AaronWiersma/LoiterGuardPcb/TopPcbV1.DXF

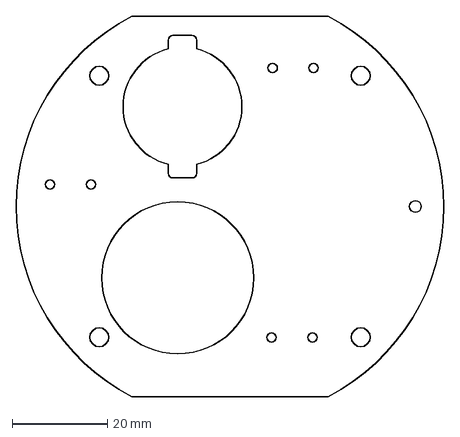
[picture p1: CAD file, 2026-02-07]
TopPcbV1.DXF
90.0 x 80.0 mm
