AaronWiersma/LoiterGuardPcb/LoiterGuardPcb.step

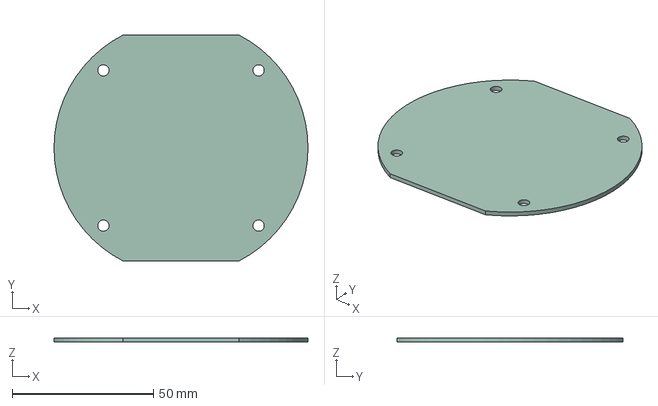
[picture p2: CAD file, 2026-02-04]
LoiterGuardPcb.step
90.0 x 80.0 x 1.51 mm
