AaronWiersma/LoiterGuardPcb/LoiterGuardPcb.kicad_pcb

## KiCad design LoiterGuardPcb.kicad_pcb (2026-02-13)

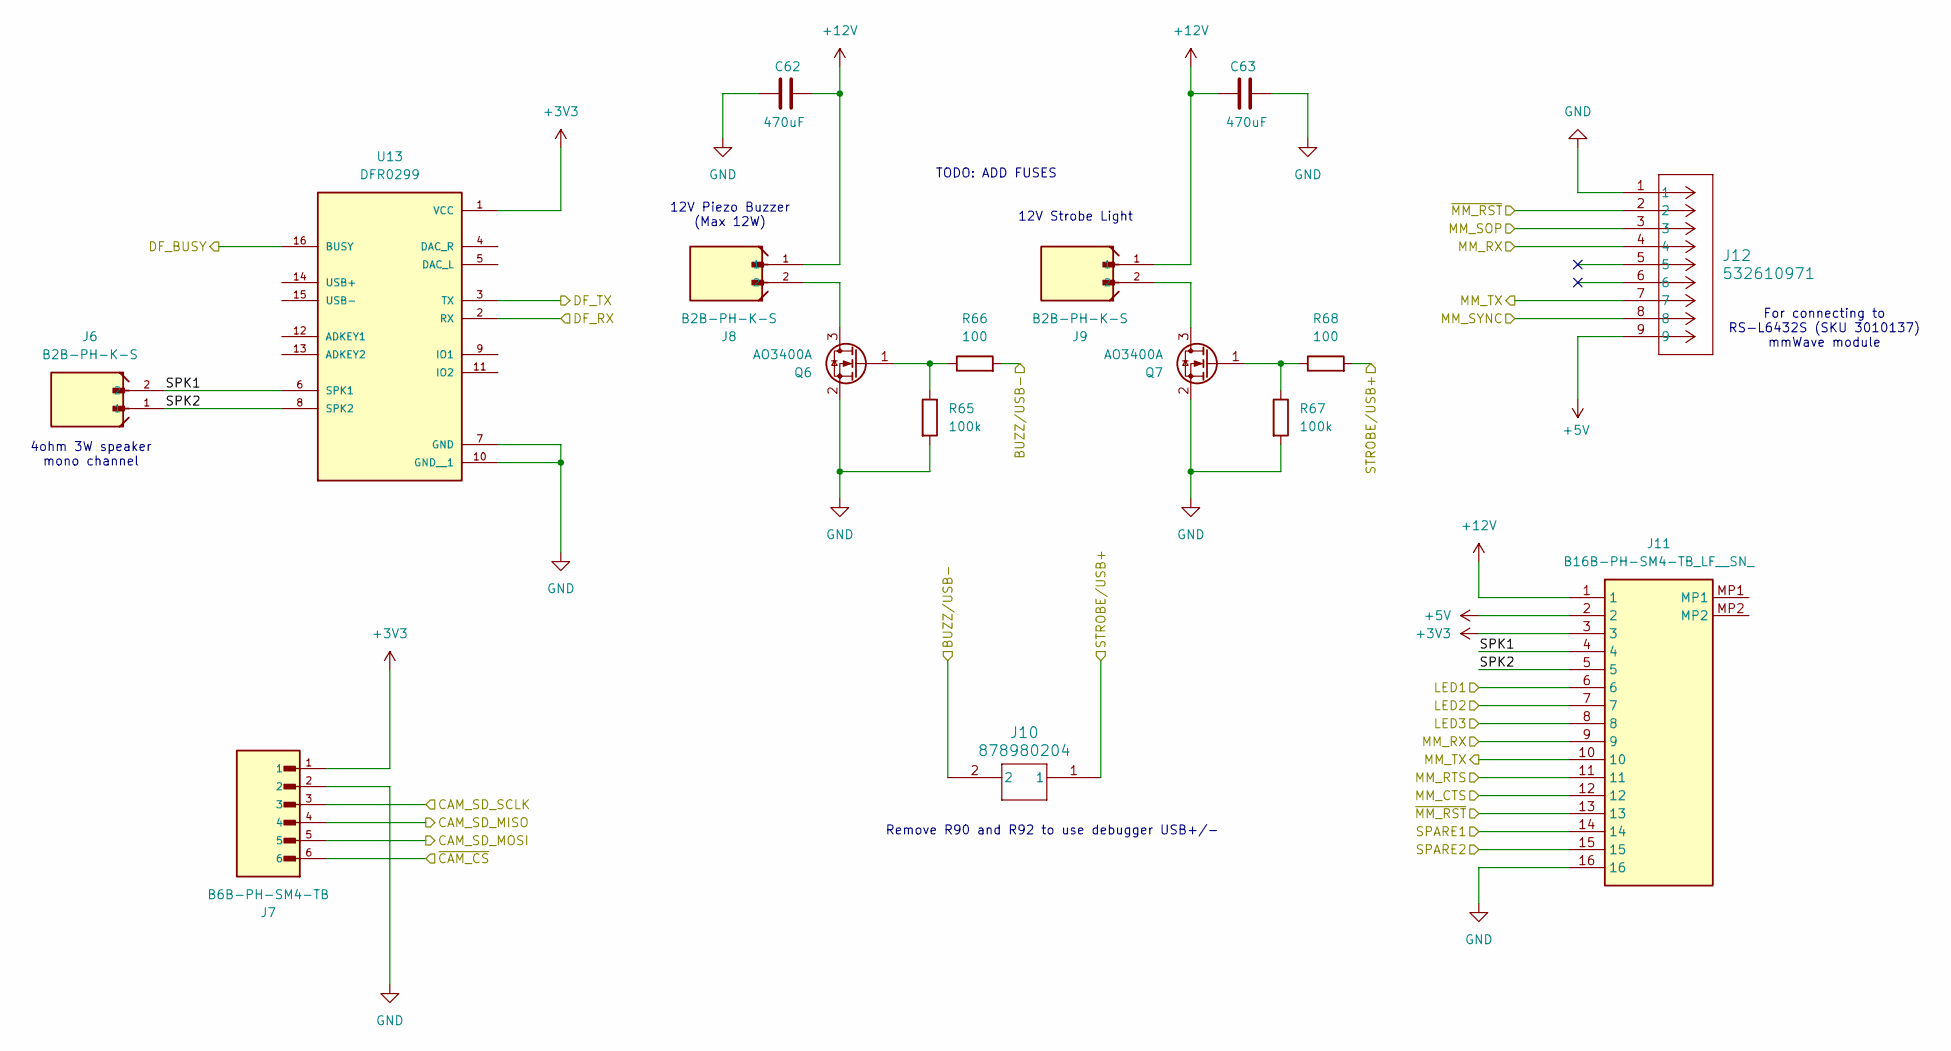
[picture p3: schematic outputs.kicad_sch]

Parts:
C62, C63: 470uF; CP_Radial_D10.0mm_P5.00mm
J6, J8, J9: B2B-PH-K-S; JST_B2B-PH-K-S
J7: B6B-PH-SM4-TB; JST_B6B-PH-SM4-TB; PARTREV N/A
J10: 878980204; 87898-0204_MOL
J11: B16B-PH-SM4-TB_LF__SN_; B16BPHSM4TBLFSN; Manufacturer_Part_Number B16B-PH-SM4-TB(LF)(SN); Mouser Part Number 306-B16BPHSM4TBLFSN
J12: 532610971; CONN_532610001-SD_09_MOL
Q6, Q7: AO3400A; SOT-23
R65, R67: 100k; R_0603_1608Metric
R66, R68: 100; R_0603_1608Metric
U13: DFR0299; MODULE_DFR0299

Connections:
+3V3: J7.1, J11.3, U13.1 (VCC); also elsewhere on the board
+5V: J11.2, J12.9; also elsewhere on the board
+12V: C62.2, C63.2, J8.1, J9.1, J11.1; also elsewhere on the board
/Expander/CAM_SD_MISO: J7.4; also elsewhere on the board
/Expander/CAM_SD_MOSI: J7.5; also elsewhere on the board
/Expander/CAM_SD_SCLK: J7.3; also elsewhere on the board
/Expander/DF_BUSY: U13.16 (BUSY); also elsewhere on the board
/Expander/MM_SOP: J12.3; also elsewhere on the board
/Expander/MM_SYNC: J12.8; also elsewhere on the board
/Expander/SPARE1: J11.15; also elsewhere on the board
/Expander/SPARE2: J11.14; also elsewhere on the board
/Expander/~MM_RST: J11.13, J12.2; also elsewhere on the board
/MCU/BUZZ/USB-: J10.2, R66.2; also elsewhere on the board
/MCU/DF_RX: U13.2 (RX); also elsewhere on the board
/MCU/DF_TX: U13.3 (TX); also elsewhere on the board
/MCU/LED1: J11.6; also elsewhere on the board
/MCU/LED2: J11.7; also elsewhere on the board
/MCU/LED3: J11.8; also elsewhere on the board
/MCU/MM_CTS: J11.12; also elsewhere on the board
/MCU/MM_RTS: J11.11; also elsewhere on the board
/MCU/MM_RX: J11.9, J12.4; also elsewhere on the board
/MCU/MM_TX: J11.10, J12.7; also elsewhere on the board
/MCU/STROBE/USB+: J10.1, R68.2; also elsewhere on the board
/MCU/~CAM_CS: J7.6; also elsewhere on the board
/Outputs/SPK1: J6.2, J11.4, U13.6 (SPK1)
/Outputs/SPK2: J6.1, J11.5, U13.8 (SPK2)
GND: C62.1, C63.1, J7.2, J11.16, J12.1, Q6.2 (S), Q7.2 (S), R65.2, R67.2, U13.7 (GND), U13.10 (GND__1); also elsewhere on the board
unnamed: J8.2, Q6.3 (D)
unnamed: Q6.1 (G), R65.1, R66.1
unnamed: J9.2, Q7.3 (D)
unnamed: Q7.1 (G), R67.1, R68.1

Notes on the sheet:
TODO: ADD FUSES
12V Strobe Light
Remove R90 and R92 to use debugger USB+/-
12V Piezo Buzzer (Max 12W)
4ohm 3W speaker mono channel
For connecting to RS-L6432S (SKU 3010137) mmWave module

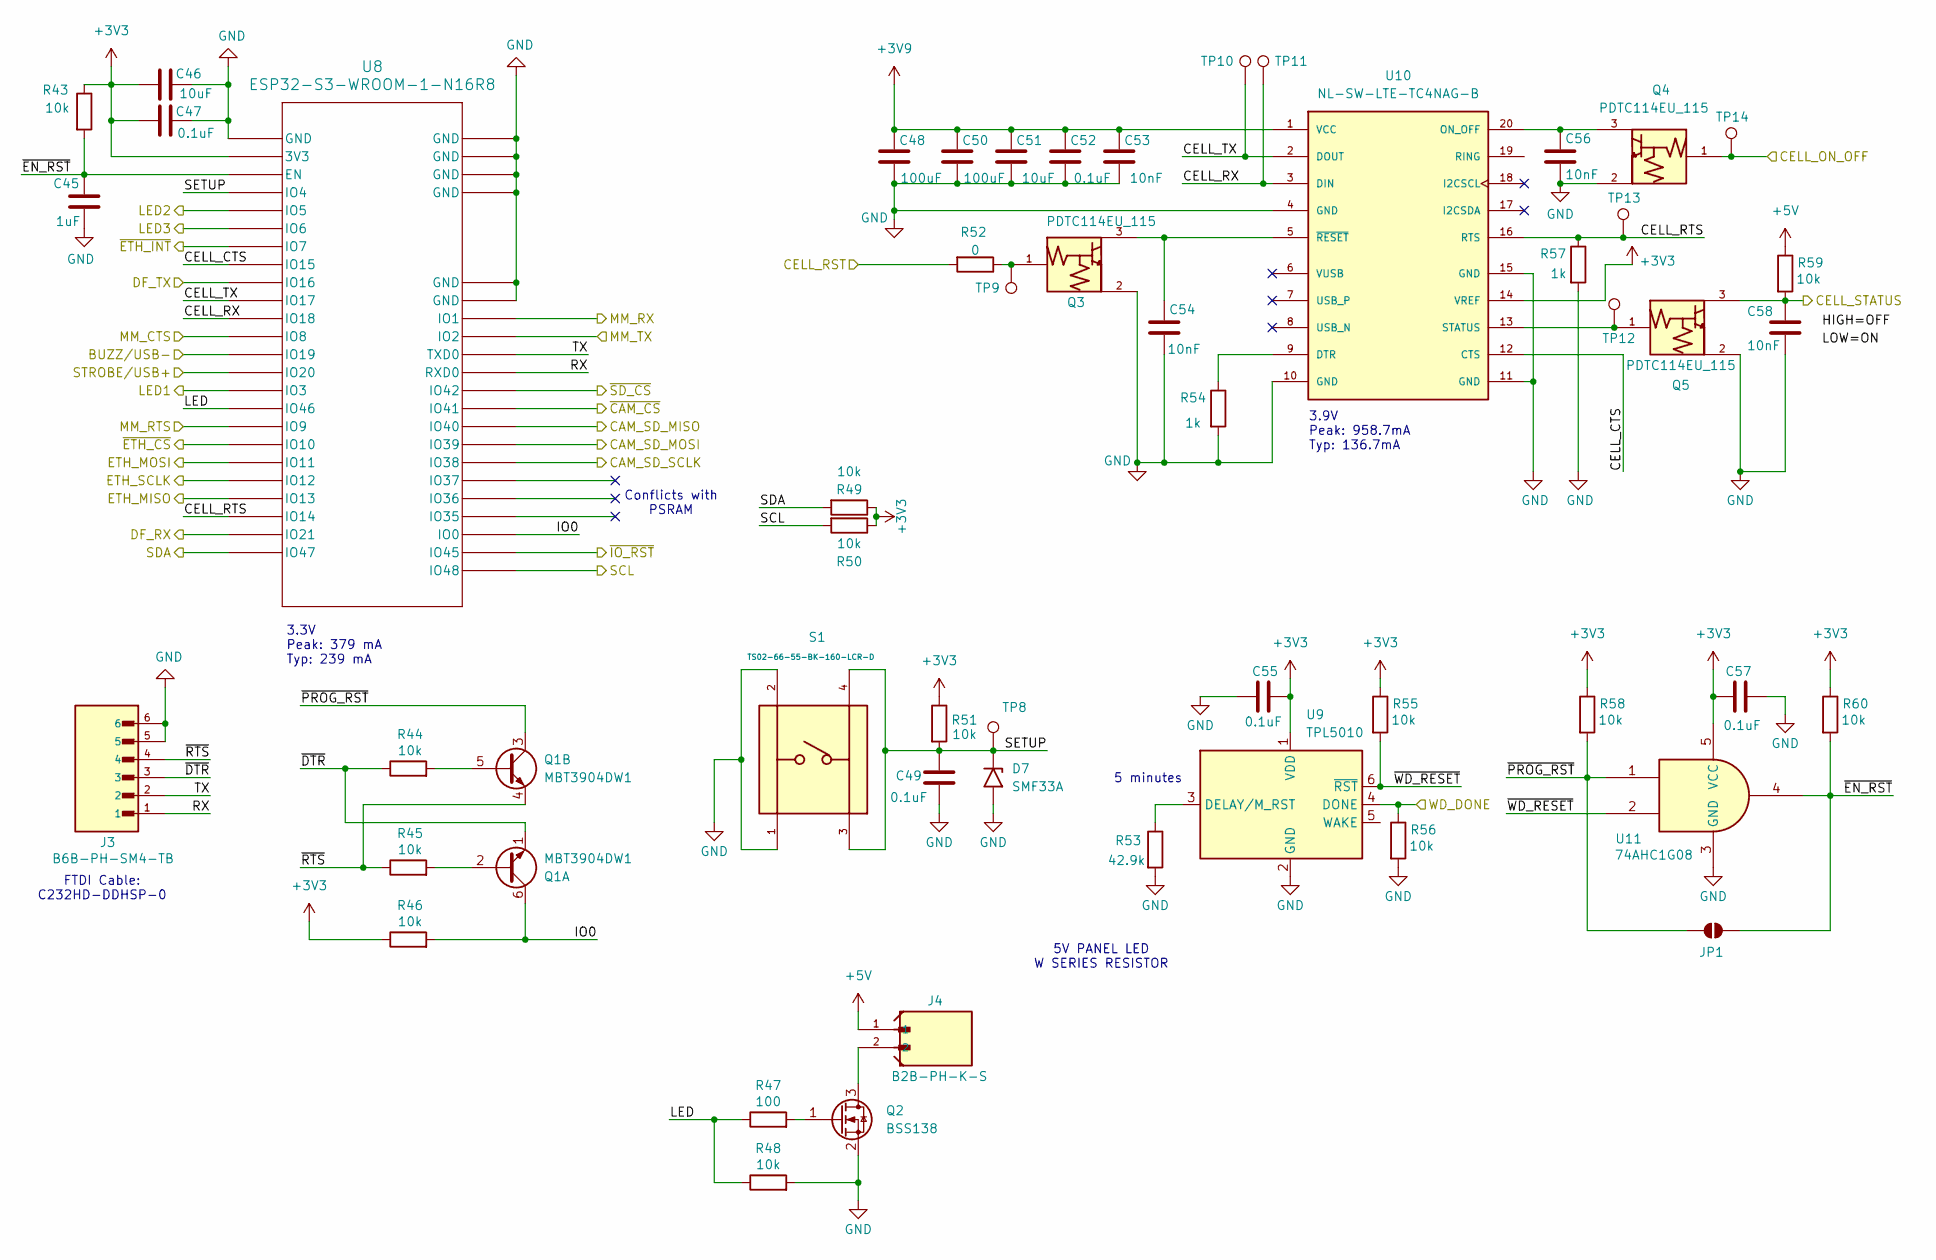
[picture p4: schematic MCU.kicad_sch]

Parts:
C45: 1uF; C_0603_1608Metric
C46, C51: 10uF; C_0805_2012Metric
C47, C49, C52, C55, C57: 0.1uF; C_0603_1608Metric
C48, C50: 100uF; CAPMP7.6X4.3_4.3N_KEM
C53, C54, C56, C58: 10nF; C_0603_1608Metric
D7: SMF33A; D_SMF
J3: B6B-PH-SM4-TB; JST_B6B-PH-SM4-TB; PARTREV N/A
J4: B2B-PH-K-S; JST_B2B-PH-K-S
JP1: SolderJumper_2_Open; SolderJumper-2_P1.3mm_Open_Pad1.0x1.5mm
Q1: MBT3904DW1; SOT-363_SC-70-6
Q2: BSS138; SOT-23
Q3, Q4, Q5: PDTC114EU_115; SOT65P210X110-3N; PARTREV 12
R43, R44, R45, R46, R48, R51, R55, R56, R58, R59, R60: 10k; R_0603_1608Metric
R47: 100; R_0603_1608Metric
R49, R50: 10k_0402_0402WGF1002TCE; R_0402_1005Metric; Tolerance 1%; MPN 0402WGF1002TCE
R52: 0; R_0603_1608Metric
R53: 42.9k; R_0603_1608Metric
R54, R57: 1k; R_0603_1608Metric
S1: TS02-66-55-BK-160-LCR-D; SW_TS02-66-55-BK-160-LCR-D; PARTREV 1.0
TP8, TP9, TP10, TP11, TP12, TP13, TP14: TestPoint; TestPoint_Pad_D2.0mm
U8: ESP32-S3-WROOM-1-N16R8; ESP32-S3-WROOM-1_EXP
U9: TPL5010; SOT-23-6
U10: NL-SW-LTE-TC4NAG-B; MODULE_NL-SW-LTE-QBG96; PARTREV 16
U11: 74AHC1G08; SOT95P280X140-5N

Connections:
+3V3: C46.1, C47.1, C55.2, C57.1, R43.1, R46.1, R49.1, R50.1, R51.1, R55.1, R58.1, R60.1, U8.2 (3V3), U9.1 (VDD), U10.14 (VREF), U11.5 (VCC); also elsewhere on the board
+3V9: C48.1, C50.1, C51.1, C52.1, C53.1, U10.1 (VCC); also elsewhere on the board
+5V: J4.1, R59.1; also elsewhere on the board
/Expander/CAM_SD_MISO: U8.33 (IO40); also elsewhere on the board
/Expander/CAM_SD_MOSI: U8.32 (IO39); also elsewhere on the board
/Expander/CAM_SD_SCLK: U8.31 (IO38); also elsewhere on the board
/Expander/CELL_ON_OFF: Q4.1, TP14.1; also elsewhere on the board
/Expander/CELL_RST: R52.2; also elsewhere on the board
/Expander/CELL_STATUS: C58.1, Q5.3, R59.2; also elsewhere on the board
/Expander/WD_DONE: R56.1, U9.4 (DONE); also elsewhere on the board
/Expander/~IO_RST: U8.26 (IO45); also elsewhere on the board
/Expander/~SD_CS: U8.35 (IO42); also elsewhere on the board
/MCU/BUZZ/USB-: U8.13 (IO19); also elsewhere on the board
/MCU/CELL_CTS: U8.8 (IO15), U10.12 (CTS)
/MCU/CELL_RTS: R57.1, TP13.1, U8.22 (IO14), U10.16 (RTS)
/MCU/CELL_RX: TP11.1, U8.11 (IO18), U10.3 (DIN)
/MCU/CELL_TX: TP10.1, U8.10 (IO17), U10.2 (DOUT)
/MCU/DF_RX: U8.23 (IO21); also elsewhere on the board
/MCU/DF_TX: U8.9 (IO16); also elsewhere on the board
/MCU/ETH_MISO: U8.21 (IO13); also elsewhere on the board
/MCU/ETH_MOSI: U8.19 (IO11); also elsewhere on the board
/MCU/ETH_SCLK: U8.20 (IO12); also elsewhere on the board
/MCU/IO0: Q1.6 (C1), R46.2, U8.27 (IO0)
/MCU/LED: R47.1, R48.1, U8.16 (IO46)
/MCU/LED1: U8.15 (IO3); also elsewhere on the board
/MCU/LED2: U8.5 (IO5); also elsewhere on the board
/MCU/LED3: U8.6 (IO6); also elsewhere on the board
/MCU/MM_CTS: U8.12 (IO8); also elsewhere on the board
/MCU/MM_RTS: U8.17 (IO9); also elsewhere on the board
/MCU/MM_RX: U8.39 (IO1); also elsewhere on the board
/MCU/MM_TX: U8.38 (IO2); also elsewhere on the board
/MCU/RX: J3.1, U8.36 (RXD0)
/MCU/SCL: R50.2, U8.25 (IO48); also elsewhere on the board
/MCU/SDA: R49.2, U8.24 (IO47); also elsewhere on the board
/MCU/SETUP: C49.1, D7.1 (A1), R51.2, S1.3, S1.4, TP8.1, U8.4 (IO4)
/MCU/STROBE/USB+: U8.14 (IO20); also elsewhere on the board
/MCU/TX: J3.2, U8.37 (TXD0)
/MCU/~CAM_CS: U8.34 (IO41); also elsewhere on the board
/MCU/~DTR: J3.3, Q1.1 (E1), R44.1
/MCU/~EN_RST: C45.2, JP1.2 (B), R43.2, R60.2, U8.3 (EN), U11.4
/MCU/~ETH_CS: U8.18 (IO10); also elsewhere on the board
/MCU/~ETH_INT: U8.7 (IO7); also elsewhere on the board
/MCU/~PROG_RST: JP1.1 (A), Q1.3 (C2), R58.2, U11.1
/MCU/~RTS: J3.4, Q1.4 (E2), R45.1
/MCU/~WD_RESET: R55.2, U9.6 (~RST), U11.2
GND: C45.1, C46.2, C47.2, C48.2, C49.2, C50.2, C51.2, C52.2, C53.2, C54.2, C55.1, C56.2, C57.2, C58.2, D7.2 (A2), J3.5, J3.6, Q2.2 (S), Q3.2, Q4.2, Q5.2, R48.2, R53.2, R54.2, R56.2, R57.2, S1.1, S1.2, U8.1 (GND), U8.40 (GND), U8.41 (GND), U8.46 (GND), U8.47 (GND), U8.48 (GND), U8.49 (GND), U9.2 (GND), U10.4 (GND), U10.10 (GND), U10.11 (GND), U10.15 (GND), U11.3 (GND); also elsewhere on the board
unnamed: Q1.2 (B1), R45.2
unnamed: Q1.5 (B2), R44.2
unnamed: J4.2, Q2.3 (D)
unnamed: Q2.1 (G), R47.2
unnamed: Q3.1, R52.1, TP9.1
unnamed: R53.1, U9.3 (DELAY/M_RST)
unnamed: R54.1, U10.9 (DTR)
unnamed: C56.1, Q4.3, U10.20 (ON_OFF)
unnamed: Q5.1, TP12.1, U10.13 (STATUS)
unnamed: C54.1, Q3.3, U10.5 (~RESET)

Notes on the sheet:
3.3V Peak: 379 mA Typ: 239 mA
3.9V Peak: 958.7mA Typ: 136.7mA
5V PANEL LED W SERIES RESISTOR
FTDI Cable: C232HD-DDHSP-0
5 minutes
Conflicts with PSRAM

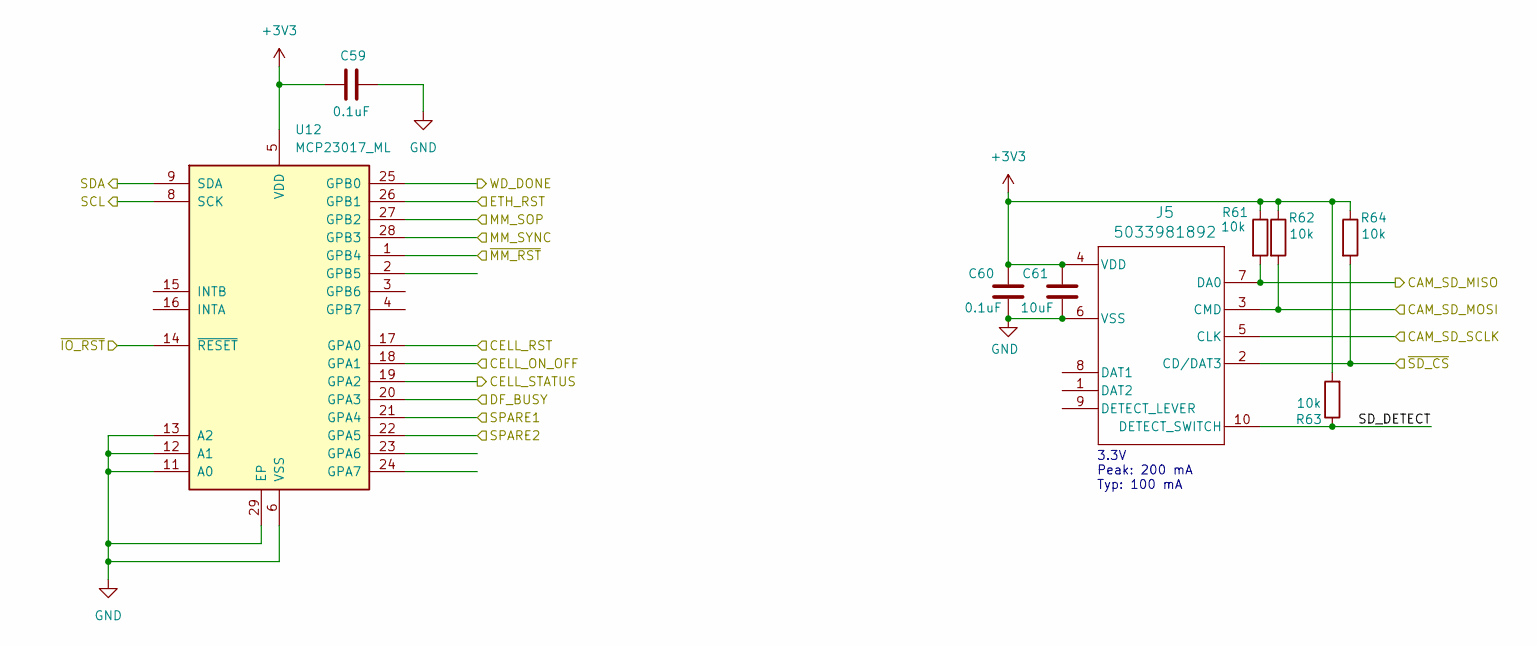
[picture p5: schematic expander.kicad_sch]

Parts:
C59, C60: 0.1uF; C_0603_1608Metric
C61: 10uF; C_0805_2012Metric
J5: 5033981892; CONN_503398-1892_MOL
R61, R62, R63, R64: 10k; R_0603_1608Metric
U12: MCP23017_ML; QFN-28-1EP_6x6mm_P0.65mm_EP4.25x4.25mm

Connections:
+3V3: C59.1, C60.1, C61.1, J5.4 (VDD), R61.1, R62.1, R63.2, R64.1, U12.5 (VDD); also elsewhere on the board
/Expander/CAM_SD_MISO: J5.7 (DA0), R61.2; also elsewhere on the board
/Expander/CAM_SD_MOSI: J5.3 (CMD), R62.2; also elsewhere on the board
/Expander/CAM_SD_SCLK: J5.5 (CLK); also elsewhere on the board
/Expander/CELL_ON_OFF: U12.18 (GPA1); also elsewhere on the board
/Expander/CELL_RST: U12.17 (GPA0); also elsewhere on the board
/Expander/CELL_STATUS: U12.19 (GPA2); also elsewhere on the board
/Expander/DF_BUSY: U12.20 (GPA3); also elsewhere on the board
/Expander/ETH_RST: U12.26 (GPB1); also elsewhere on the board
/Expander/MM_SOP: U12.27 (GPB2); also elsewhere on the board
/Expander/MM_SYNC: U12.28 (GPB3); also elsewhere on the board
/Expander/SD_DETECT: J5.10 (DETECT_SWITCH), R63.1
/Expander/SPARE1: U12.21 (GPA4); also elsewhere on the board
/Expander/SPARE2: U12.22 (GPA5); also elsewhere on the board
/Expander/WD_DONE: U12.25 (GPB0); also elsewhere on the board
/Expander/~IO_RST: U12.14 (~RESET); also elsewhere on the board
/Expander/~MM_RST: U12.1 (GPB4); also elsewhere on the board
/Expander/~SD_CS: J5.2 (CD/DAT3), R64.2; also elsewhere on the board
/MCU/SCL: U12.8 (SCK); also elsewhere on the board
/MCU/SDA: U12.9 (SDA); also elsewhere on the board
GND: C59.2, C60.2, C61.2, J5.6 (VSS), U12.6 (VSS), U12.11 (A0), U12.12 (A1), U12.13 (A2), U12.29 (EP); also elsewhere on the board

Notes on the sheet:
3.3V Peak: 200 mA Typ: 100 mA

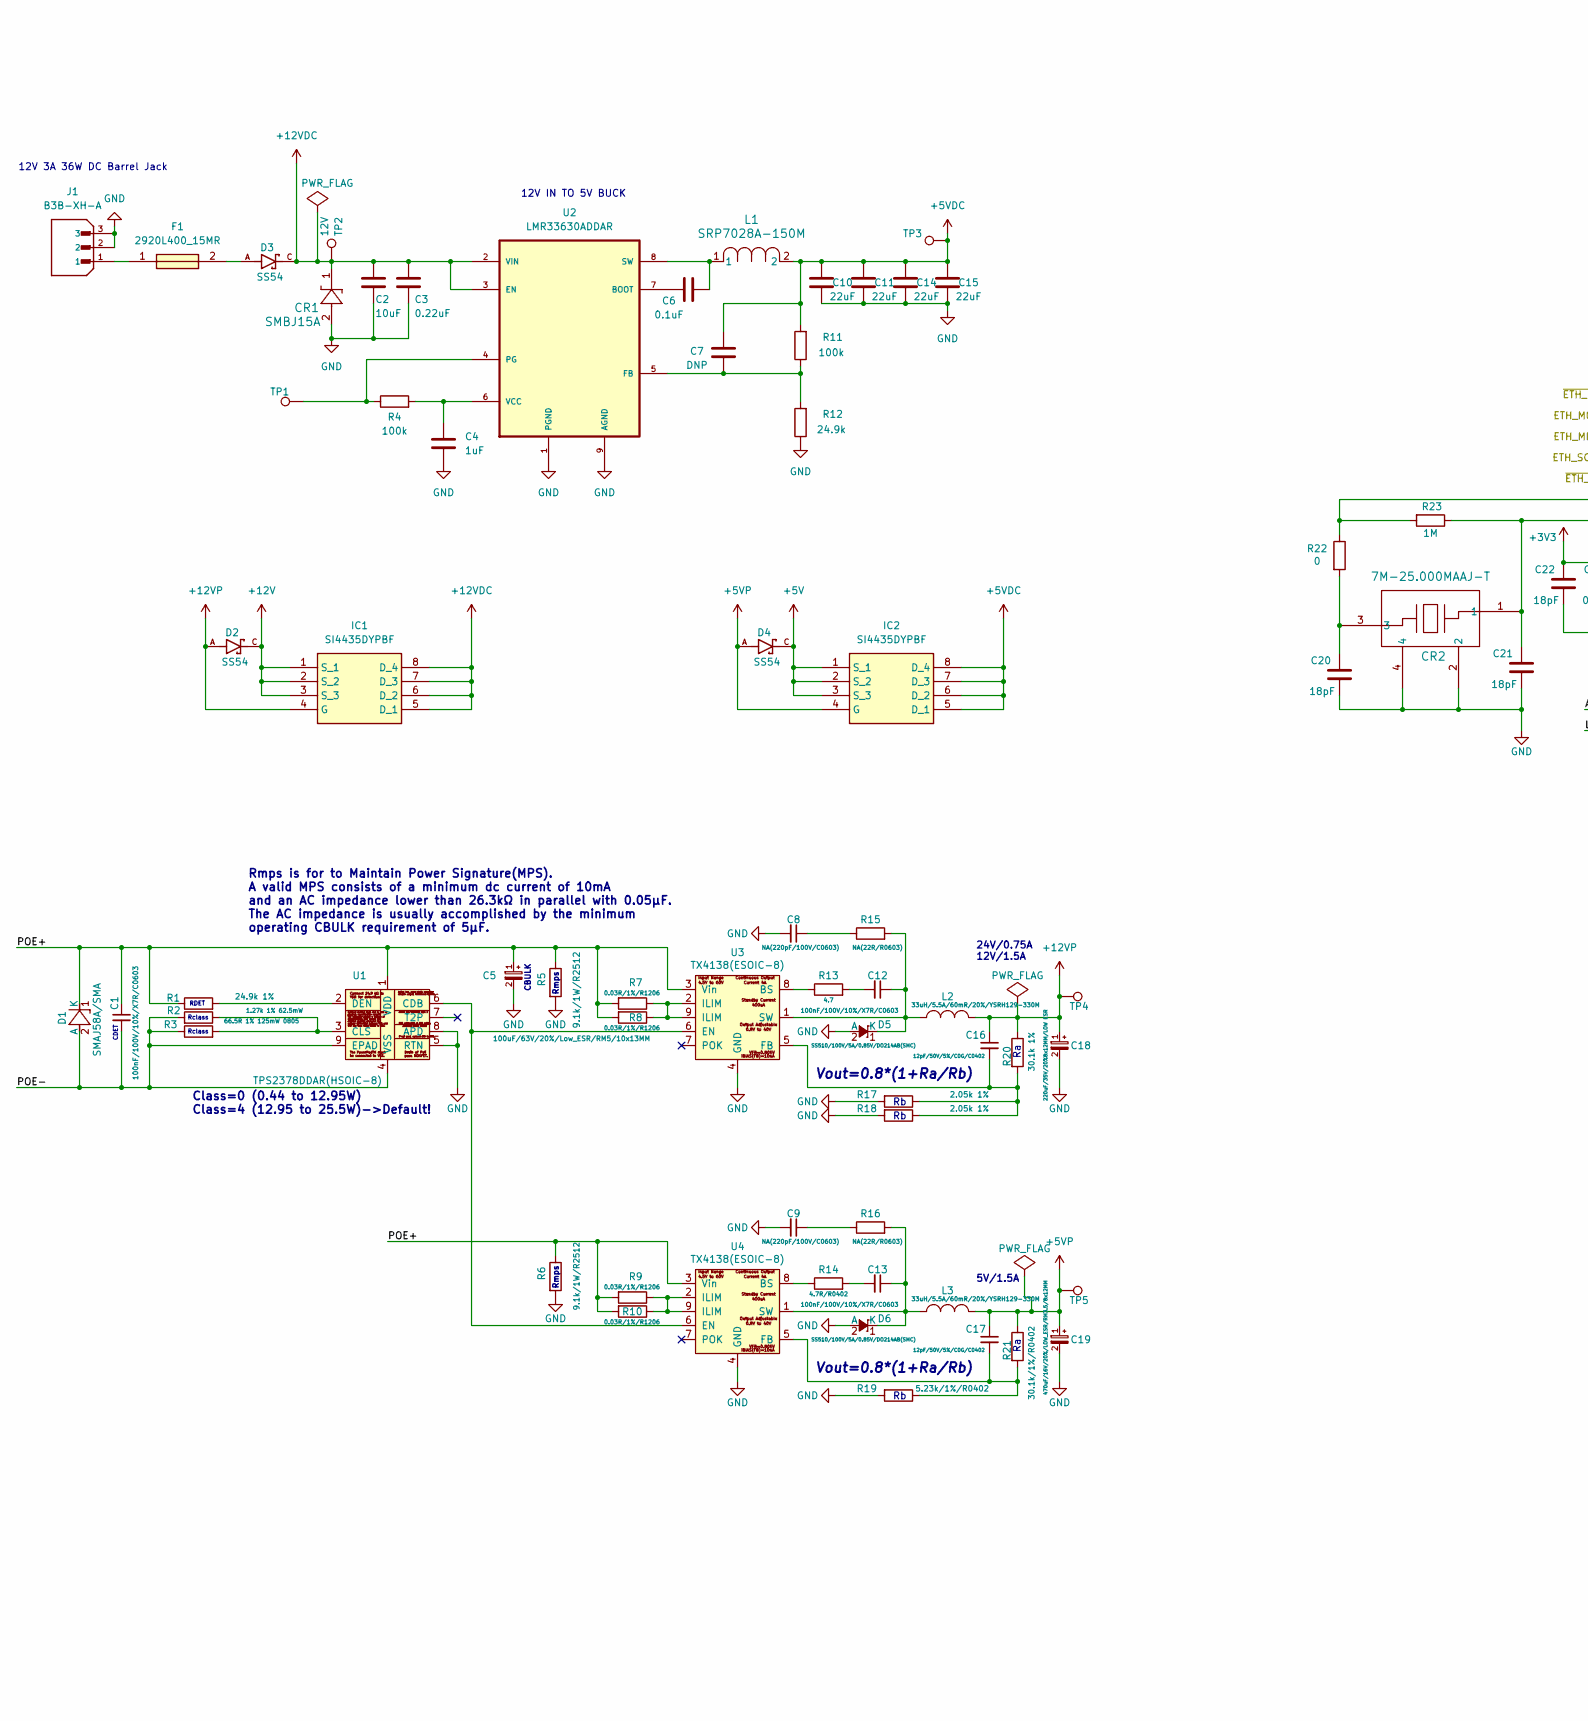
[picture p6: schematic ESP32-PoE2_Rev_B.kicad_sch, part in row 1, column 1]

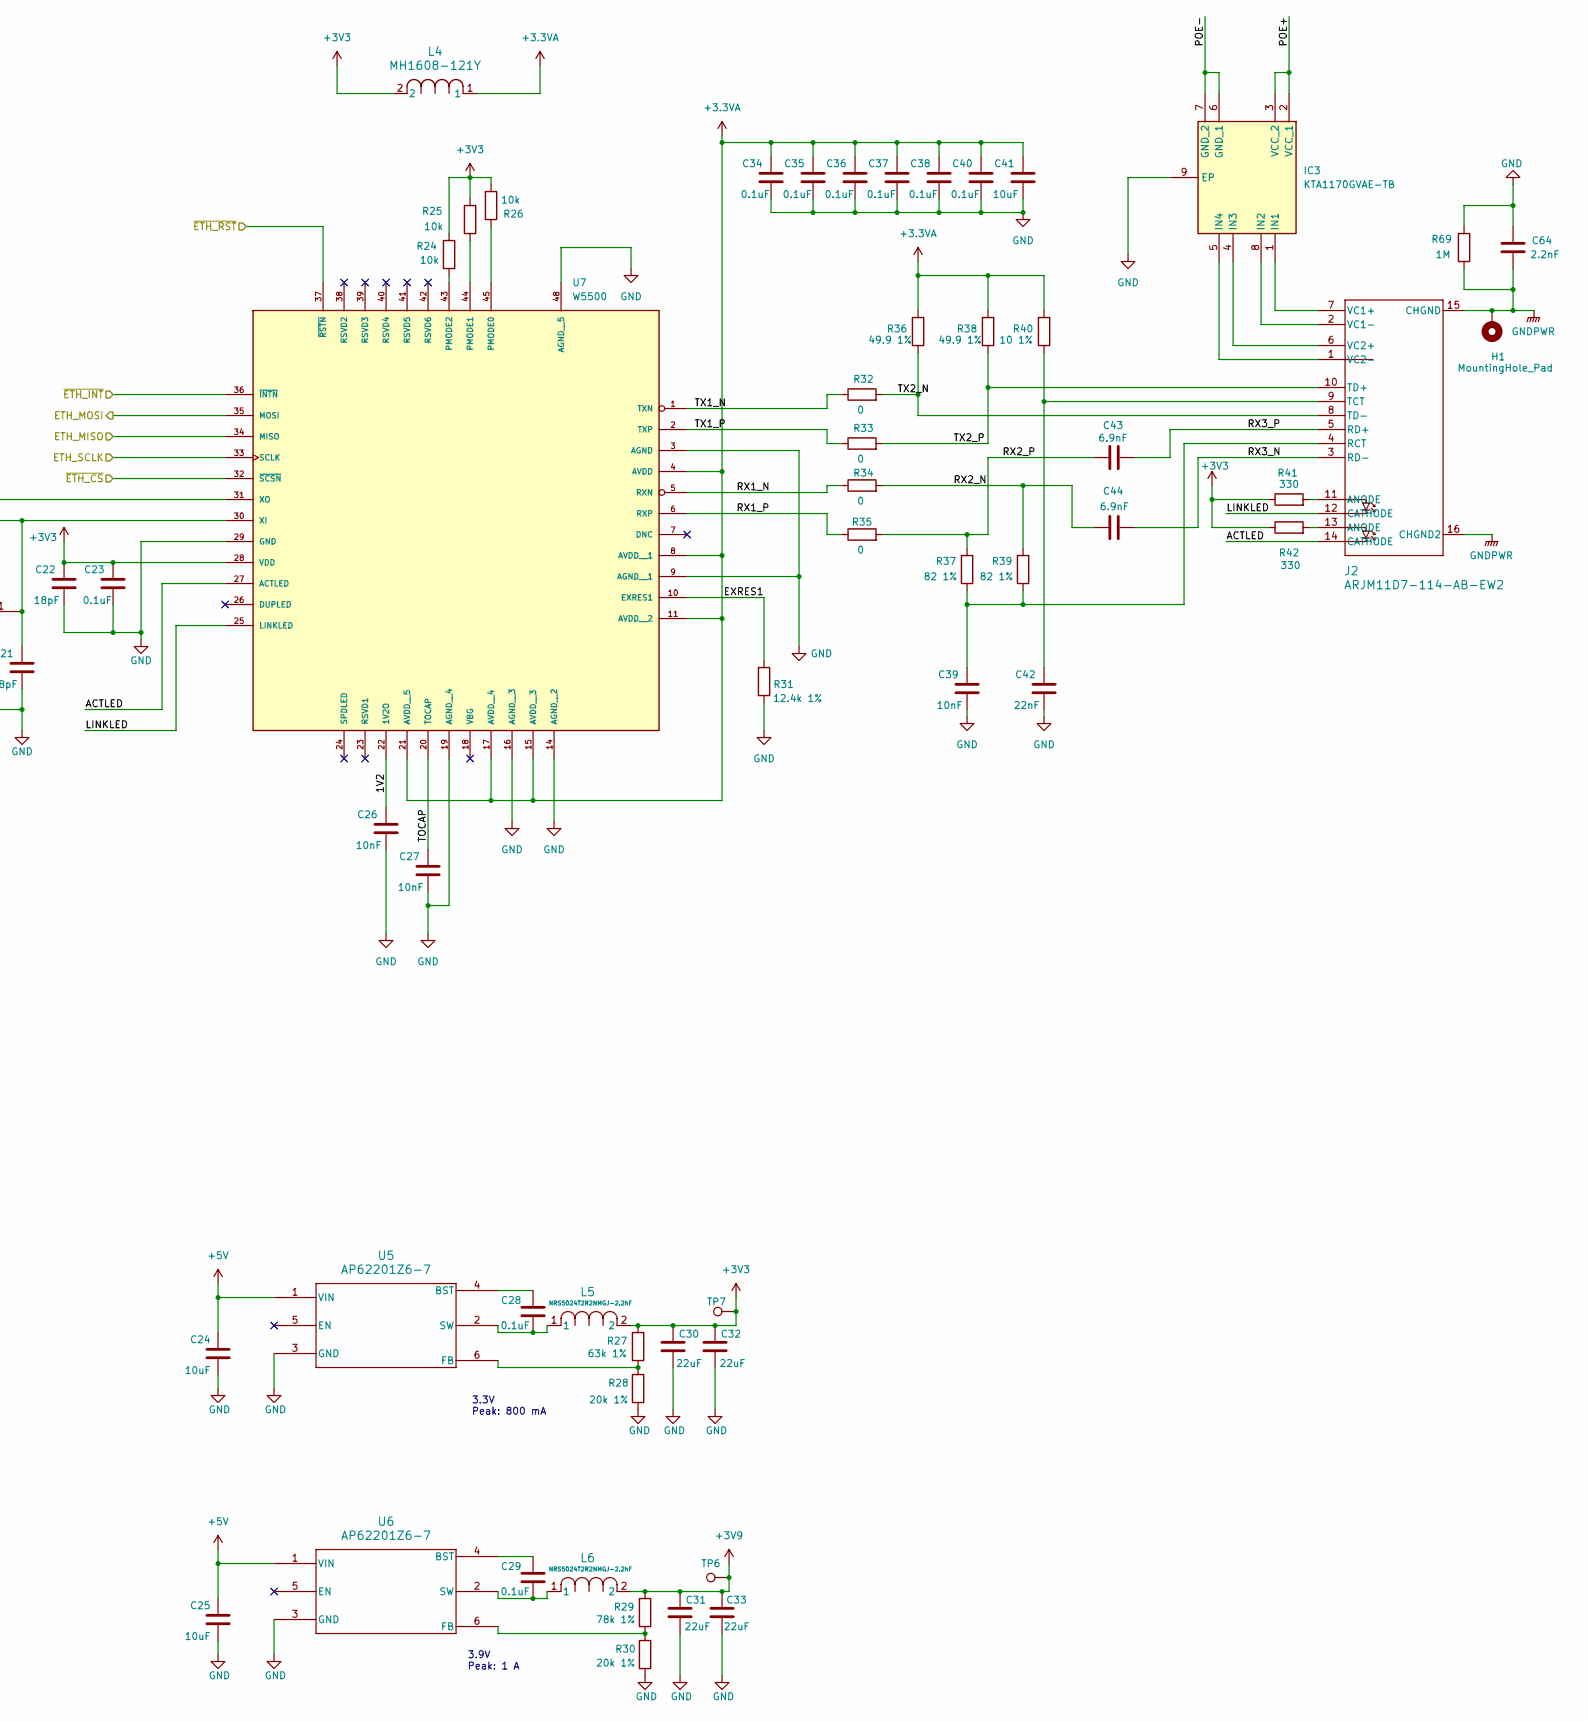
[picture p7: schematic ESP32-PoE2_Rev_B.kicad_sch, part in row 1, column 2]

Parts:
C1: 100nF/100V/10%/X7R/C0603; C_0603_1608Metric
C2, C24, C25: 10uF; C_0805_2012Metric
C3: 0.22uF; C_0603_1608Metric
C4: 1uF; C_0603_1608Metric
C5: 100uF/63V/20%/Low_ESR/RM5/10x13MM; CPOL-RM5mm_10.0x16.0mm_PTH
C6, C23, C28, C29, C34, C35, C36, C37, C38, C40: 0.1uF; C_0603_1608Metric
C7: DNP; C_0603_1608Metric
C8, C9: NA(220pF/100V/C0603); C_0603_5MIL_DWS
C10, C11, C14, C15, C30, C31, C32, C33: 22uF; C_0805_2012Metric
C12, C13: 100nF/100V/10%/X7R/C0603; C_0603_5MIL_DWS
C16, C17: 12pF/50V/5%/C0G/C0402; C_0402_5MIL_DWS
C18: 220uF/35V/20%8x12MM/LOW ESR; CPOL-RM3.5mm_8.0x11.5mm_PTH
C19: 470uF/16V/20%/LOW_ESR/RM3.5/8x12MM; CPOL-RM3.5mm_8.0x11.5mm_PTH
C20, C21, C22: 18pF; C_0603_1608Metric
C26, C27, C39: 10nF; C_0603_1608Metric
C41: 10uF; C_0603_1608Metric
C42: 22nF; C_1206_3216Metric
C43, C44: 6.9nF; C_1206_3216Metric
C64: 2.2nF; C_1812_4532Metric
CR1: SMBJ15A; DO-214AASMB_J-BEND_LTF
CR2: 7M-25.000MAAJ-T; CRYSTAL_TXC_7M
D1: SMAJ58A/SMA; SMA-KA
D2, D3, D4: SS54; DIOM7959X265N; PARTREV 31 Aug 2016
D5, D6: SS510/100V/5A/0.85V/DO214AB(SMC); DO214AB(SMC)_1(K)-2(A)
F1: 2920L400_15MR; 2920L07560MR; Manufacturer_Part_Number 2920L400/15MR; Mouser Part Number 576-2920L400/15MR
H1: MountingHole_Pad; MountingHole_3mm_Pad_TopOnly
IC1, IC2: SI4435DYPBF; SOIC127P600X175-8N; Manufacturer_Part_Number SI4435DYPBF; Mouser Part Number 942-SI4435DYPBF
IC3: KTA1170GVAE-TB; SON65P400X400X80-9N; Manufacturer_Part_Number KTA1170GVAE-TB; Mouser Part Number 389-KTA1170GVAE-TB
J1: B3B-XH-A; JST_B3B-XH-A; PARTREV 7/4/21
J2: ARJM11D7-114-AB-EW2; CONN_ARJM11D7-114-AB-EW2_ABR
L1: SRP7028A-150M; IND_SRP7028A_BRN
L2, L3: 33uH/5.5A/60mR/20%/YSRH129-330M; HSMRH129_12.0x12.5x9.5(max)
L4: MH1608-121Y; IND_BOURNS_MH1608
L5, L6: NRS5024T2R2NMGJ-2.2hF; IND_NRS5024_TAY
R1: 24.9k 1%; R_0402_5MIL_DWS
R2: 1.27k 1% 62.5mW; R_0402_5MIL_DWS
R3: 66.5R 1% 125mW 0805; R_0805_5MIL_DWS
R4, R11: 100k; R_0603_1608Metric
R5, R6: 9.1k/1W/R2512; R_2512_MM_DWS
R7, R8, R9, R10: 0.03R/1%/R1206; R_1206_5MIL_DWS
R12: 24.9k; R_0603_1608Metric
R13: 4.7; R_0402_5MIL_DWS
R14: 4.7R/R0402; R_0402_5MIL_DWS
R15, R16: NA(22R/R0603); R_0603_5MIL_DWS
R17, R18: 2.05k 1%; R_0402_5MIL_DWS
R19: 5.23k/1%/R0402; R_0402_5MIL_DWS
R20: 30.1k 1%; R_0402_5MIL_DWS
R21: 30.1k/1%/R0402; R_0402_5MIL_DWS
R22, R32, R33, R34, R35: 0; R_0603_1608Metric
R23: 1M; R_0603_1608Metric
R24, R25, R26: 10k; R_0603_1608Metric
R27: 63k 1%; R_0603_1608Metric
R28, R30: 20k 1%; R_0603_1608Metric
R29: 78k 1%; R_0603_1608Metric
R31: 12.4k 1%; R_0603_1608Metric
R36, R38: 49.9 1%; R_0603_1608Metric
R37, R39: 82 1%; R_0603_1608Metric
R40: 10 1%; R_0603_1608Metric
R41, R42: 330; R_0603_1608Metric
R69: 1M; R_1206_3216Metric
TP1: TestPoint; TestPoint_Pad_D2.0mm
TP2: 12V; TestPoint_Pad_D2.0mm
TP3: 5VIN; TestPoint_Pad_D2.0mm
TP4, TP5, TP7: 3V3; TestPoint_Pad_D2.0mm
TP6: 3V9; TestPoint_Pad_D2.0mm
U1: TPS2378DDAR(HSOIC-8); ESOIC-8
U2: LMR33630ADDAR; VREG_LM5017MR_NOPB
U3, U4: TX4138(ESOIC-8); ESOIC-8
U5, U6: AP62201Z6-7; SOT563-Z6_1_DIO
U7: W5500; QFP50P900X900X160-48N

Connections:
+3.3VA: C34.1, C35.1, C36.1, C37.1, C38.1, C40.1, C41.1, L4.1, R36.2, R38.2, R40.2, U7.4 (AVDD), U7.8 (AVDD__1), U7.11 (AVDD__2), U7.15 (AVDD__3), U7.17 (AVDD__4), U7.21 (AVDD__5)
+3V3: C22.1, C23.1, C30.2, C32.2, L4.2, L5.2, R24.2, R25.2, R26.1, R27.2, R41.1, R42.1, TP7.1, U7.28 (VDD); also elsewhere on the board
+3V9: C31.2, C33.2, L6.2, R29.2, TP6.1; also elsewhere on the board
+5V: C24.2, C25.2, D4.C, IC2.1 (S_1), IC2.2 (S_2), IC2.3 (S_3), U5.1 (VIN), U6.1 (VIN); also elsewhere on the board
+5VDC: C7.1, C10.1, C11.1, C14.1, C15.1, IC2.5 (D_1), IC2.6 (D_2), IC2.7 (D_3), IC2.8 (D_4), L1.2, R11.2, TP3.1
+5VP: C17.1, C19.1 (+), D4.A, IC2.4 (G), L3.2, R21.1, TP5.1
+12V: D2.C, IC1.1 (S_1), IC1.2 (S_2), IC1.3 (S_3); also elsewhere on the board
+12VDC: C2.1, C3.1, CR1.1, D3.C, IC1.5 (D_1), IC1.6 (D_2), IC1.7 (D_3), IC1.8 (D_4), TP2.1, U2.2 (VIN), U2.3 (EN)
+12VP: C16.1, C18.1 (+), D2.A, IC1.4 (G), L2.2, R20.1, TP4.1
/Expander/ETH_RST: U7.37 (~RSTN); also elsewhere on the board
/MCU/ETH_MISO: U7.35 (MOSI); also elsewhere on the board
/MCU/ETH_MOSI: U7.34 (MISO); also elsewhere on the board
/MCU/ETH_SCLK: U7.33 (SCLK); also elsewhere on the board
/MCU/~ETH_CS: U7.32 (~SCSN); also elsewhere on the board
/MCU/~ETH_INT: U7.36 (~INTN); also elsewhere on the board
/Poe/1V2: C26.1, U7.22 (1V2O)
/Poe/ACTLED: J2.14 (CATHODE), U7.27 (ACTLED)
/Poe/EXRES1: R31.1, U7.10 (EXRES1)
/Poe/LINKLED: J2.12 (CATHODE), U7.25 (LINKLED)
/Poe/POE+: C1.1, C5.1 (+), D1.1 (K), IC3.2 (VCC_1), IC3.3 (VCC_2), R1.1, R5.1, R6.1, R7.2, R8.2, R9.2, R10.2, U1.1 (VDD), U3.3 (Vin), U4.3 (Vin)
/Poe/POE-: C1.2, D1.2 (A), IC3.6 (GND_1), IC3.7 (GND_2), R2.2, R3.1, U1.4 (VSS), U1.9 (EPAD)
/Poe/RX1_N: R34.1, U7.5 (RXN)
/Poe/RX1_P: R35.1, U7.6 (RXP)
/Poe/RX2_N: C44.1, R34.2, R39.2
/Poe/RX2_P: C43.1, R35.2, R37.2
/Poe/RX3_N: C44.2, J2.3 (RD-)
/Poe/RX3_P: C43.2, J2.5 (RD+)
/Poe/TOCAP: C27.1, U7.20 (TOCAP)
/Poe/TX1_N: R32.1, U7.1 (TXN)
/Poe/TX1_P: R33.1, U7.2 (TXP)
/Poe/TX2_N: J2.8 (TD-), R32.2, R36.1
/Poe/TX2_P: J2.10 (TD+), R33.2, R38.1
GND: C2.2, C3.2, C4.2, C5.2 (-), C8.2, C9.2, C10.2, C11.2, C14.2, C15.2, C18.2 (-), C19.2 (-), C20.2, C21.2, C22.2, C23.2, C24.1, C25.1, C26.2, C27.2, C30.1, C31.1, C32.1, C33.1, C34.2, C35.2, C36.2, C37.2, C38.2, C39.2, C40.2, C41.2, C42.2, C64.1, CR1.2, CR2.2, CR2.4, D5.2 (A), D6.2 (A), IC3.9 (EP), J1.2, J1.3, R5.2, R6.2, R12.1, R17.2, R18.2, R19.2, R28.1, R30.1, R31.2, R69.2, U1.5 (RTN), U1.8 (APD), U2.1 (PGND), U2.9 (AGND), U3.4 (GND), U4.4 (GND), U5.3 (GND), U6.3 (GND), U7.3 (AGND), U7.9 (AGND__1), U7.14 (AGND__2), U7.16 (AGND__3), U7.19 (AGND__4), U7.29 (GND), U7.48 (AGND__5); also elsewhere on the board
GNDPWR: C64.2, H1.1, J2.15 (CHGND), J2.16 (CHGND2), R69.1
unnamed: C8.1, R15.1
unnamed: C9.1, R16.1
unnamed: C12.2, R13.2
unnamed: C13.2, R14.2
unnamed: C20.1, CR2.3, R22.2
unnamed: D3.A, F1.2
unnamed: C12.1, D5.1 (K), L2.1, R15.2, U3.1 (SW)
unnamed: C13.1, D6.1 (K), L3.1, R16.2, U4.1 (SW)
unnamed: F1.1, J1.1
unnamed: IC3.1 (IN1), J2.7 (VC1+)
unnamed: IC3.8 (IN2), J2.2 (VC1-)
unnamed: IC3.4 (IN3), J2.6 (VC2+)
unnamed: IC3.5 (IN4), J2.1 (VC2-)
unnamed: J2.11 (ANODE), R41.2
unnamed: J2.13 (ANODE), R42.2
unnamed: C39.1, J2.4 (RCT), R37.1, R39.1
unnamed: C42.1, J2.9 (TCT), R40.1
unnamed: R7.1, R8.1, U3.2 (ILIM), U3.9 (ILIM)
unnamed: R9.1, R10.1, U4.2 (ILIM), U4.9 (ILIM)
unnamed: U1.6 (CDB), U3.6 (EN), U4.6 (EN)
unnamed: R2.1, R3.2, U1.3 (CLS)
unnamed: R1.2, U1.2 (DEN)
unnamed: C6.2, U2.7 (BOOT)
unnamed: C7.2, R11.1, R12.2, U2.5 (FB)
unnamed: R4.1, TP1.1, U2.4 (PG)
unnamed: C6.1, L1.1, U2.8 (SW)
unnamed: C4.1, R4.2, U2.6 (VCC)
unnamed: R13.1, U3.8 (BS)
unnamed: C16.2, R17.1, R18.1, R20.2, U3.5 (FB)
unnamed: R14.1, U4.8 (BS)
unnamed: C17.2, R19.1, R21.2, U4.5 (FB)
unnamed: C28.2, U5.4 (BST)
unnamed: R27.1, R28.2, U5.6 (FB)
unnamed: C28.1, L5.1, U5.2 (SW)
unnamed: C29.2, U6.4 (BST)
unnamed: R29.1, R30.2, U6.6 (FB)
unnamed: C29.1, L6.1, U6.2 (SW)
unnamed: R26.2, U7.45 (PMODE0)
unnamed: R25.1, U7.44 (PMODE1)
unnamed: R24.1, U7.43 (PMODE2)
unnamed: C21.1, CR2.1, R23.1, U7.30 (XI)
unnamed: R22.1, R23.2, U7.31 (XO)

Notes on the sheet:
5V/1.5A
CDET
Rmps is for to Maintain Power Signature(MPS). A valid MPS consists of a minimum dc current of 10mA and an AC impedance lower than 26.3kΩ in parallel with 0.05μF. The AC impedance is usually accomplished by the minimum operating CBULK requirement of 5μF.
RDET
3.3V Peak: 800 mA
Rmps
Rclass
12V IN TO 5V BUCK
24V/0.75A 12V/1.5A
Vout=0.8*(1+Ra/Rb)
12V 3A 36W DC Barrel Jack
Class=0 (0.44 to 12.95W) Class=4 (12.95 to 25.5W)->Default!
3.9V Peak: 1 A
CBULK
