AaronWiersma/LoiterGuardPcb/LoiterGuardPcb.kicad_pcb

## KiCad design LoiterGuardPcb.kicad_pcb (continued)

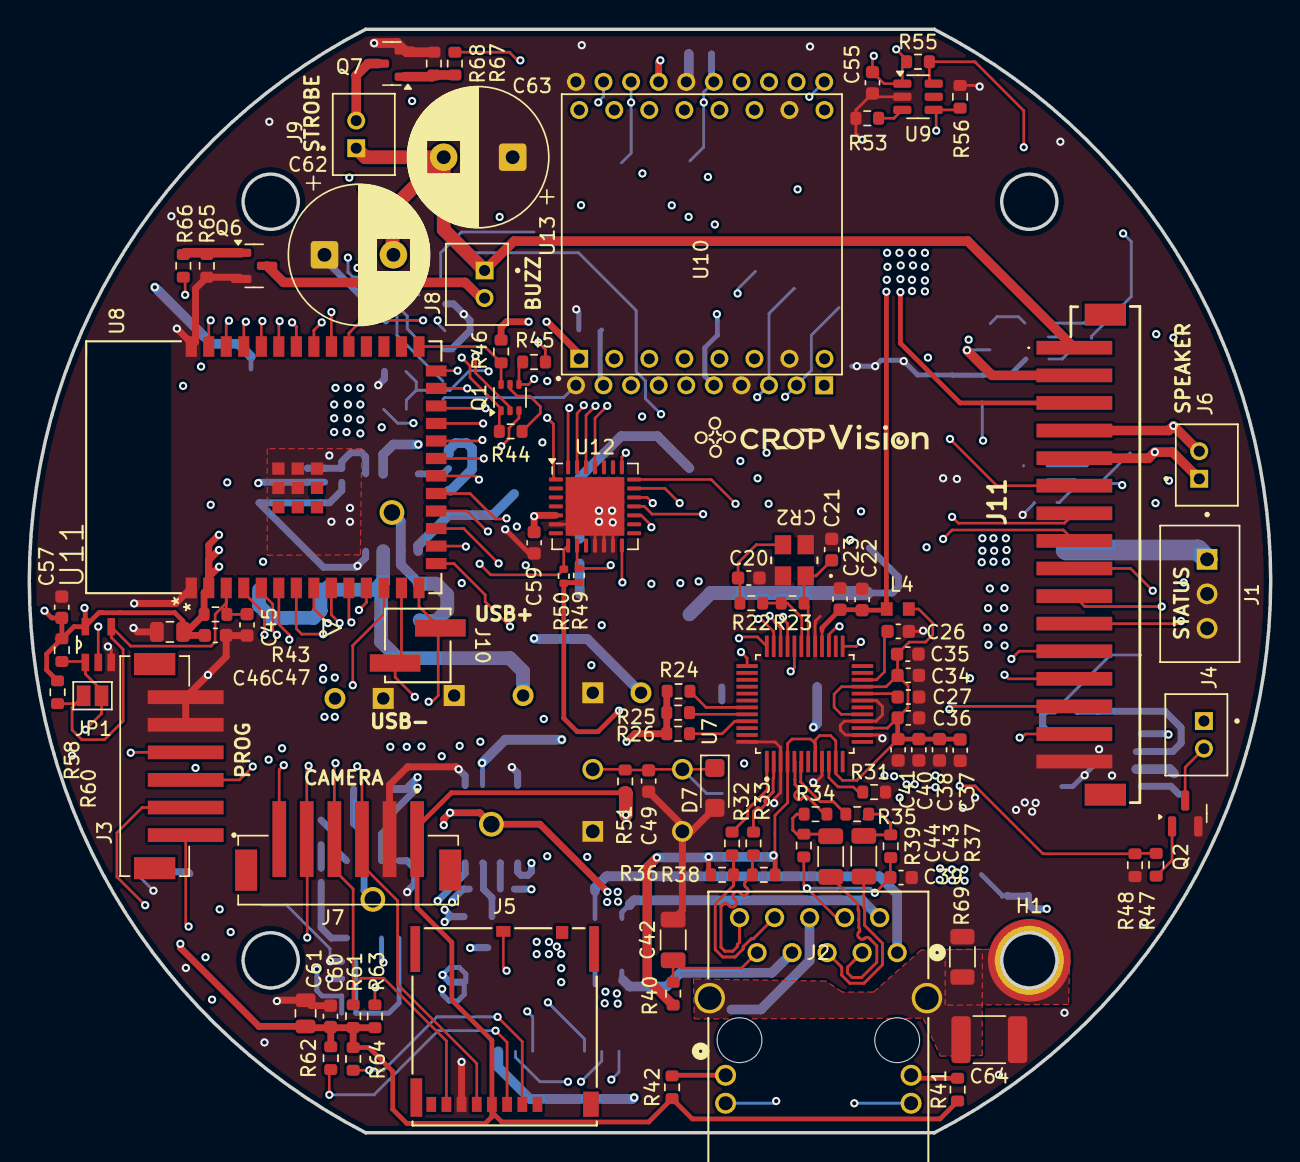
[picture p8: board LoiterGuardPcb.kicad_pcb from above]

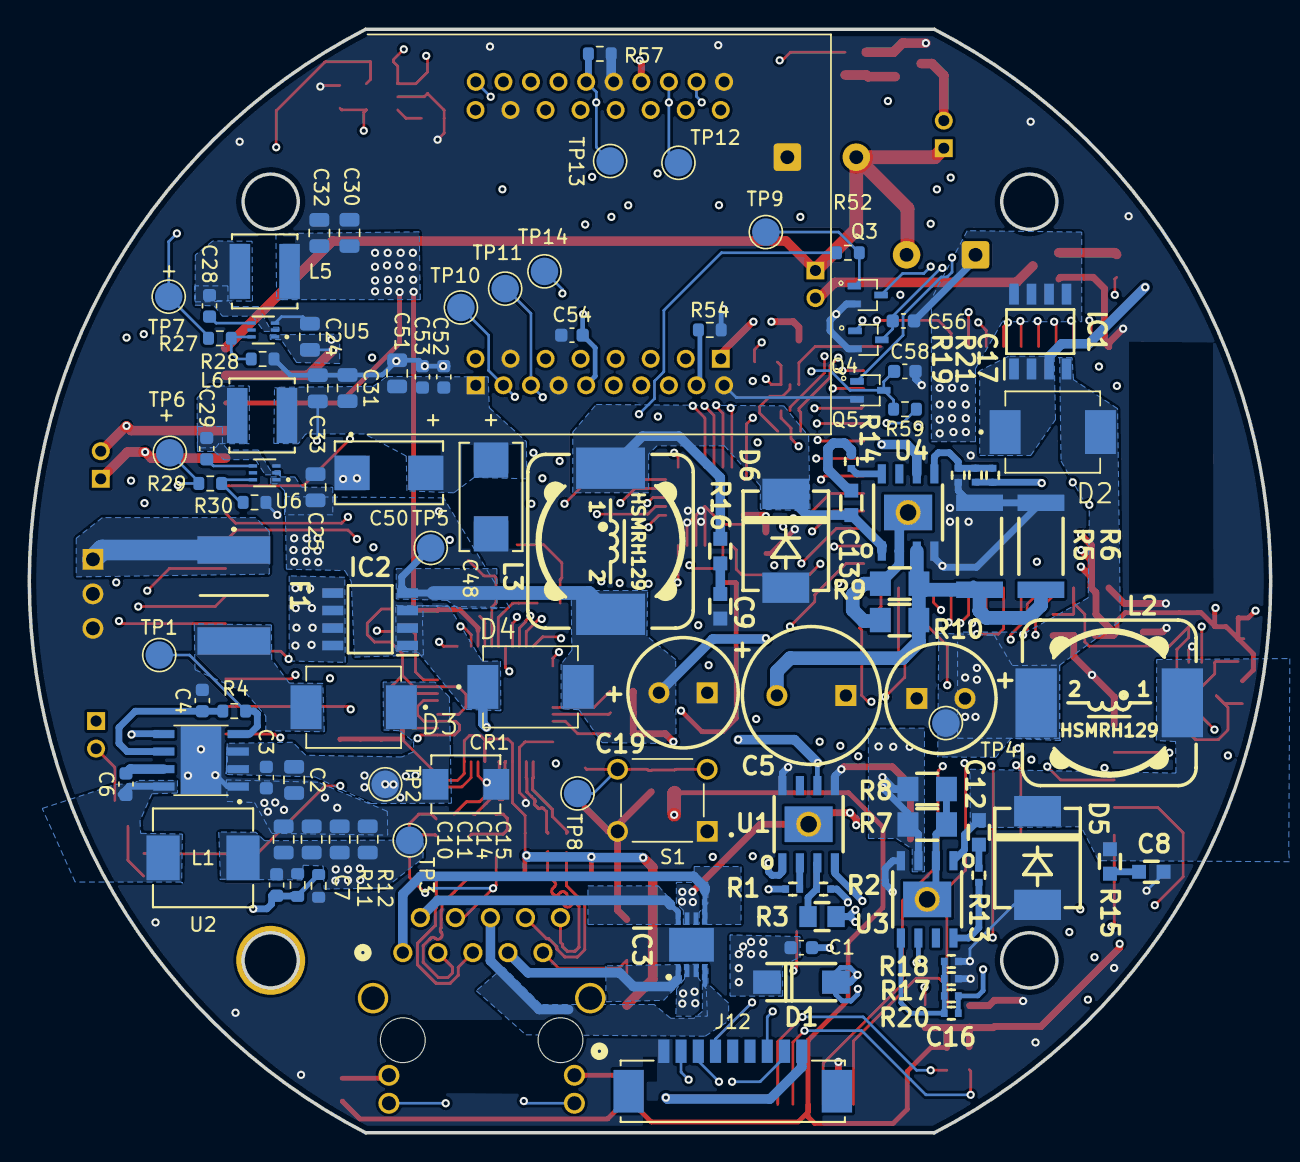
[picture p9: board LoiterGuardPcb.kicad_pcb from below]

Board: 6 copper layers, 90.0 x 80.0 mm, 201 parts (106 on the bottom side), 136 nets.
