AaronWiersma/LoiterGuardPcb/(commit log)

2026-02-07 updated poe schematic
    [ESP32-PoE2_Rev_B.kicad_sch, LoiterGuardPcb.kicad_pcb, LoiterGuardPcb.kicad_sch, MCU.kicad_sch, TopPcbV1.DXF, ai-camera-rev3.2.kicad_sch, outputs.kicad_sch]
2026-02-08 GPIOs shouldn't have any conflicts
    [ESP32-PoE2_Rev_B.kicad_sch, LoiterGuardPcb.kicad_pcb, LoiterGuardPcb.kicad_sch, MCU.kicad_sch, expander.kicad_sch, outputs.kicad_sch]
2026-02-08 when using fpc ovo camera
    [expander.kicad_sch]
2026-02-09 put all the components on the pcb on traces
    [ESP32-PoE2_Rev_B.kicad_sch, LoiterGuardPcb.kicad_pcb, MCU.kicad_sch, expander.kicad_sch, outputs.kicad_sch]
2026-02-10 wip - started traces for layout
    [ESP32-PoE2_Rev_B.kicad_sch, LoiterGuardPcb.kicad_pcb, LoiterGuardPcb.kicad_sch, MCU.kicad_sch, expander.kicad_sch, outputs.kicad_sch]
2026-02-11 wip - still working on layout
    [LoiterGuardPcb.kicad_pcb]
2026-02-11 layout checkin
    [LoiterGuardPcb.kicad_pcb]
2026-02-12 WIP - starting moving reference silkscreens around
    [ESP32-PoE2_Rev_B.kicad_sch, LoiterGuardPcb.kicad_pcb]
2026-02-13 moved 12V connector to the front layer
    [LoiterGuardPcb.kicad_pcb]
